HEYAHONG/CoreBoard-001/HW/ReadMe.md

# 开发工具

采用立创EDA(专业版)作为PCB设计工具,官网地址:[https://pro.lceda.cn/](https://pro.lceda.cn/)

# PCB板

- [CoreBoard-001](CoreBoard-001)
