HEYAHONG/CoreBoard-001/FW/package/ReadMe.md

# 软件包列表

- [FirstBootInit](FirstBootInit):第一次启动的初始化，用于进行一些设置（如WIFI设置）。
- [ExtBoard](ExtBoard):管理扩展板。
