HEYAHONG/CoreBoard-001/HW/CoreBoard-001/SCH_Schematic-CoreBoard-001_2024-04-29.pdf

# 100 100 DEBUG⁻TX DEBUG⁻RX 3V³

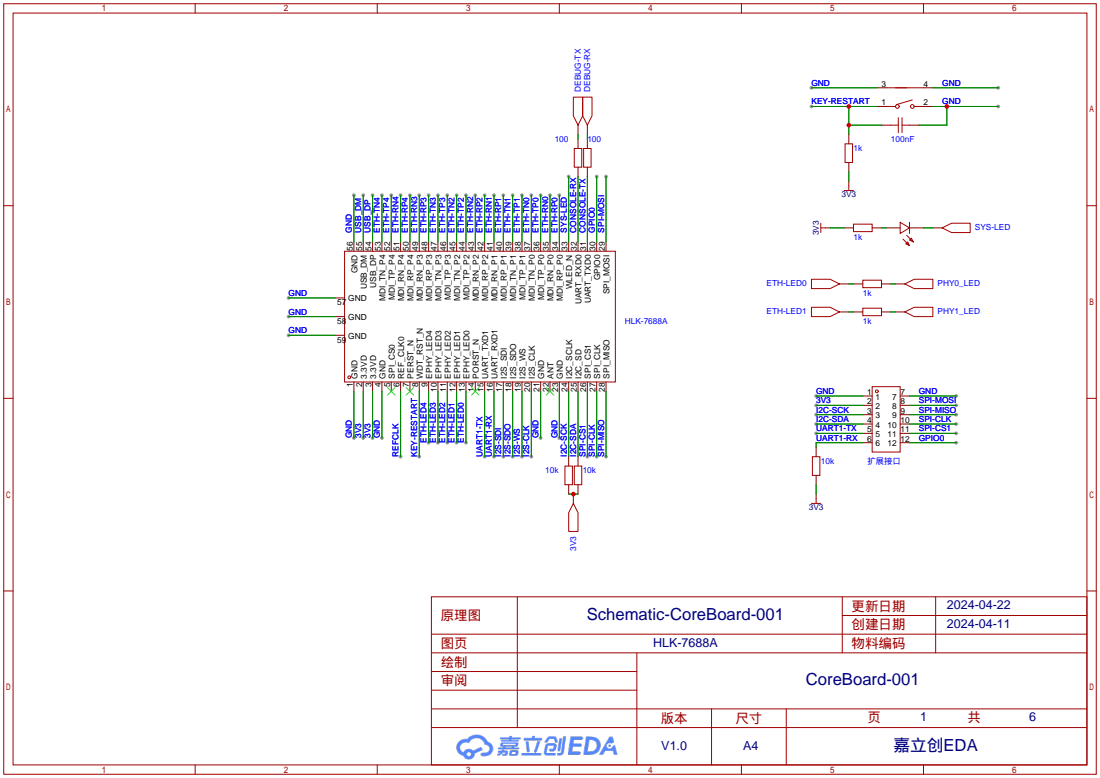
[picture p2: page 1]

ETH-RN4
GND 57 GND ⁵⁶ USB_DM ⁵⁵

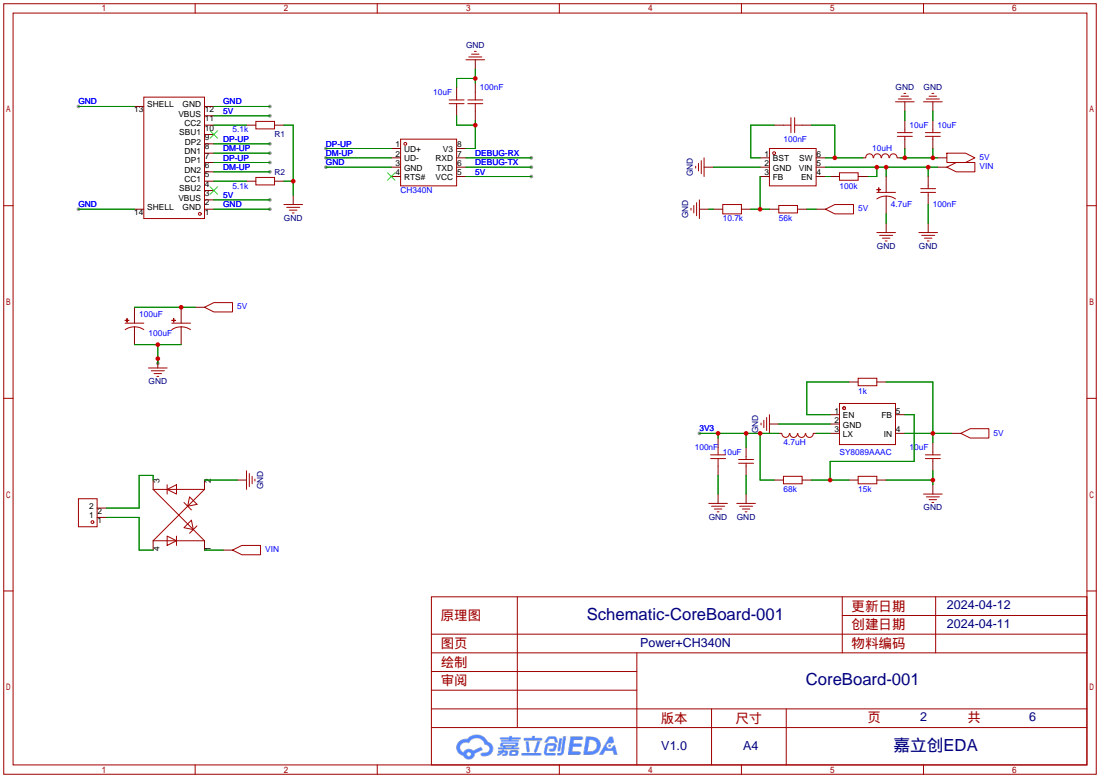
[picture p3: page 2]

审阅

绘制

### 创建日期 物料编码

原理图 | 更新日期

图页

# CoreBoard-001

6

2024-04-11

# 2024-04-11 Schematic-CoreBoard-001

3

DS1307

5V

I2C-SDA

I2C-SCK

GND

GND

1 2

CR1220-2ZX

X1 1
X2 2
VBAT 3
GND 4

SDA 5

SCL 6

SQW/OUT 7

VCC 8

DS1307M/TR

32.768kHz

C2
12pF

C1
12pF

审阅

绘制

### 创建日期 物料编码

原理图 | 更新日期

图页

# CoreBoard-001

6

2024-04-11

# 2024-04-11 Schematic-CoreBoard-001

4

## USB

SH2

SH1

GND 4

D+ 3

D- 2

VCC 5V | 1
USB_DM
USB_DP
GND
GND
GND

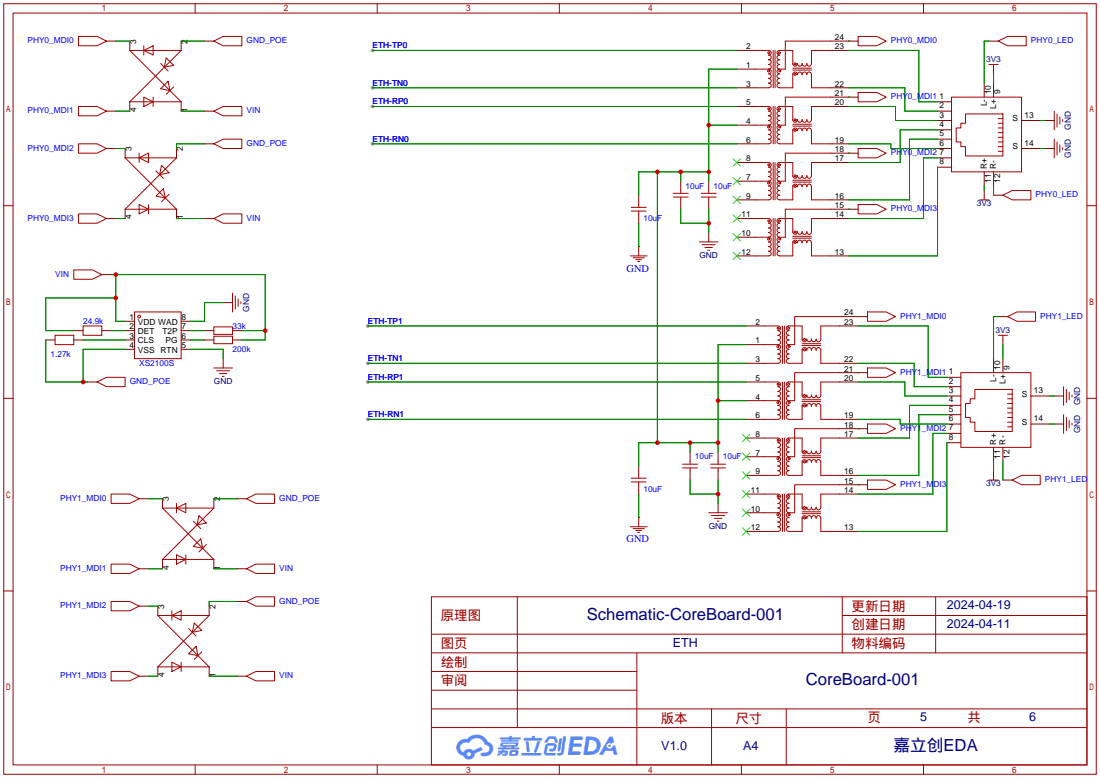
[picture p4: page 5]

审阅

绘制

### 创建日期 物料编码

原理图 | 更新日期

图页

# CoreBoard-001

6

2024-04-22

# 2024-04-12 Schematic-CoreBoard-001

6

## Audio

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
GND | 2
I2C-SCK
I2S-SDI
I2S-WS | I2S-CLK I2S-SDO

I2C-SDA

3V3

1

1
2

2

GND
REFCLK
