HEYAHONG/CoreBoard-001/(list of files, drawings)

Other design files:
HW/CoreBoard-001/CoreBoard-001_2024-04-29.epro
