HEYAHONG/CoreBoard-001/(commit log)

2024-04-29 初步添加
    [CoreBoard-001_2024-04-29.epro]
2024-04-29 修复文档错误
2024-04-29 修复错误
2024-04-29 更新说明
2024-04-29 修复文字错误
2024-04-30 初步创建FW目录结构
2024-04-30 每次编译均进行feeds更新
2024-04-30 添加local_feeds,将本地软件包存储在本仓库
2024-04-30 将Git信息作为版本号及版本代码
2024-05-01 添加CoreBoard-001支持： 1.修改厂商名为HYH/hyh，修改产品名称为CoreBoard-001/coreboard-001. 2.添加DS1307的设备树支持。 3.将WLAN灯改为系统灯。 4.仅启用WAN（网口0）、LAN（网口1），其余网口不启用。
2024-05-01 修复BUG
2024-05-01 添加DS1307初始化
2024-05-01 调整默认时区
2024-05-02 完善补丁脚本
2024-05-04 启用常用工具的完整版本，如which、coreutils、awk、sed、grep、usbutils等
2024-05-04 添加libserialport，用于串口访问
2024-05-05 启用一些功能（/dev/mem、/dev/kmem、devtmpfs、kexec）
2024-05-05 添加spidev支持，可使用/dev/spi0.1访问spi接口
2024-05-05 调整内核构建选项设置
2024-05-05 更新defconfig
2024-05-05 添加蓝牙(USB)支持
2024-05-05 添加dbus-cxx，方便C++开发使用DBus用做IPC。openwrt自带的ubus虽然体积小，但是使用C++开发起来比较吃力。
2024-05-06 添加需要忽略的文件
2024-05-06 添加ExtBoardD的基本目录结构
2024-05-06 启用ExtBoardDeamon
2024-05-06 [ExtBoardD] 添加对syslog的初始化与反初始化
2024-05-07 [ExtBoardD] 初步添加DBus接口
2024-05-07 切换到系统级别的DBus，要求使用root用户启动ExtBoardD
2024-05-07 [ExtBoard] 添加lsExtBoard
2024-05-10 修改mac地址获取方式
2024-05-10 读取USB设备信息，包括但不限于USB总线号、USB设备地址、USB设备路径、厂商名称、产品名称、串口设备名称、块设备名称。
2024-05-11 修复libusb热插拔未起效的bug（未进行事件处理）,完善USB热插拔信息打印
2024-05-11 [ExtBoard] 延长等待驱动加载的时间，使USB识别更稳定
2024-05-23 自动添加RNDIS网卡，方便4G上网(注意：以太网的优先级高于USB网卡，故而当WAN口接入网线时默认路由不走4G口，但可在套接字中绑定4G网卡所在IP地址走4G通道)
2024-05-29 更新openwrt
2024-05-29 更新默认配置
2024-06-09 自动更新子模块源代码
2024-06-21 完善wifi设置
2025-01-16 更新配置文件
2025-01-16 更新spidev补丁
2025-01-22 添加HCppBox
2025-01-22 添加漏掉的文件
2025-02-20 更新HCppBox
2025-03-31 更新openwrt，更新HCppBox
2025-06-06 更新HCppBox与openwrt
2025-10-18 [openwrt-23.05] 更新openwrt
2025-10-18 [openwrt-23.05] 添加distclean目标，更新menuconfig
2025-10-18 [openwrt-23.05] 修复distclean目标错误
2025-10-18 [package] 更新HCppBox
2025-10-19 [openwrt-24.10] 初步添加基于openwrt24.10的固件
2025-10-19 [FW] 启用ttyd便于调试
2025-10-19 [openwrt-24.10] 修复补丁路径
2025-10-20 [FW] 因多个固件共用，本地软件包的类型由src-link改为src-cpy
2025-10-23 [openwrt 24.10] 更新openwrt
2025-10-23 [FW/package] 更新第三方软件包
2025-10-23 [FW/package] openwrt24.10对git源代码的处理不同，最终校验也不同
2025-10-25 [FW] 更新distclean的依赖与属性
2025-10-30 添加blackmagic，可通过调试器（若CMSIS-DAP、J-LINK等）对其支持的MCU烧录/调试
2026-01-22 更新HCppBox、更新openwrt
2026-08-21 [FW] 更新HCppBox
2026-11-02 [.github] 使用opencode与deepseek初步添加工作流
